esoren/denmark/README.md

This code is for an STM32F4-based amplifier controller board. More info is available on my website.
