esoren/denmark/pcb/denmark_bom.xlsx

Digikey P/N | QTY | Reference | Doubled | Description
399-C0603C104K8RAC7867CT-ND | 10 | C1 C5 C6 C7 C8 C9 C10 C13 C14 C15 | 20 | 100nf 0603 capacitor
587-GMK316AB7475MLHTCT-ND | 2 | C3 C11 | 4 | 4.7uF 1206 low ESR
1189-1513-1-ND | 1 | C2 | 2 | 10uF 8mm cap
475-1410-1-ND | 6 | MODE1 MODE2 MODE3 MODE4 STAT1 STAT2 | 12 | green 0805 led
732-4987-1-ND | 4 | MON1 MON2 MON3 MON4 | 8 | yellow 0805 led
475-1278-1-ND | 6 | FAULT1 FAULT2 FAULT3 FAULT4 FAULT5 FAULT6 | 12 | red 0805 led
497-STM32F401RET7-ND | 1 | U1 | 2 | stm32f4 mcu
RNCP0603FTD1K00CT-ND | 4 | R3 R8 | 8 | 1k 0603 resistor
311-100KHRCT-ND | 3 | R4 R5 R6 | 6 | 100k 0603 resistor
311-2.20KHRCT-ND | 2 | R7 R9 | 4 | 2.2k 0603 resistor
RMCF0201FT10K0CT-ND | 7 | R11 R19 R21 R23 R24 R26 R31 | 14 | 10k 0603 resistor
311-4.7KGRCT-ND | 2 | R17 R18 | 4 | 4.7k 0603 resistor
RMCF0603ZT0R00CT-ND | 3 | R14 R15 R16 | 6 | 0 0603 resistor
VSSR16-330-JI-ND | 2 | R1 R2 | 4 | resistor network - 330
865-1261-1-ND | 1 | U2 | 2 | FRAM
497-1242-1-ND | 1 | IC2 | 2 | 1117 LDO
XC1922-ND | 1 | Q1 | 2 | 8.0 MHz Crystal
CP-1408-ND | 1 | RCA | 2 | RCA connector
102-4000-ND | 1 | USB | 2 | USB connector
296-SN74AHC1G08DBV3CT-ND | 1 | IC1 | 2 | AND Gate
SW400-ND | 5 | S1 S2 S3 S4 S5 | 10 | tactile switch
A98333-ND | 6 | 5V THERM1 THERM2 THERM3 X1 X4 | 12 | 2 pin terminal block 0.1"
A98334-ND | 4 | X2 LF_AMP MF_AMP HF_AMP | 8 | 3 pin terminal block 0.1":
A98335-ND | 1 | FAN | 2 | 4 pin terminal block 0.1"
A98336-ND | 1 | X3 | 2 | 5 pin terminal block 0.1"
MMBT3904LT1HTSA1CT-ND | 7 | T1 T2 T3 T5 T6 T7 T9 | 14 | npn transistor sot23
1276-1187-1-ND | 2 | C4 C12 | 4 | 20p 0603 capacitor
CR0603-JW-331ELFCT-ND | 2 | R29 R30 | 4 | 330 0603 resistor
118-CR0603-JW-221ELFCT-ND | 1 | R12 | 2 | 220 0603 resistor
CR0603-JW-471ELFCT-ND | 1 | R13 | 2 | 470 0603 resistor
2N7002-FDICT-ND | 1 | T8 | 2 | NMOS switch
1727-2097-1-ND | 1 | D1 | 2 | 3v3 zener diode
