esoren/denmark/pcb/denmark.brd

## EAGLE design pcb/denmark.brd (2023-03-16)

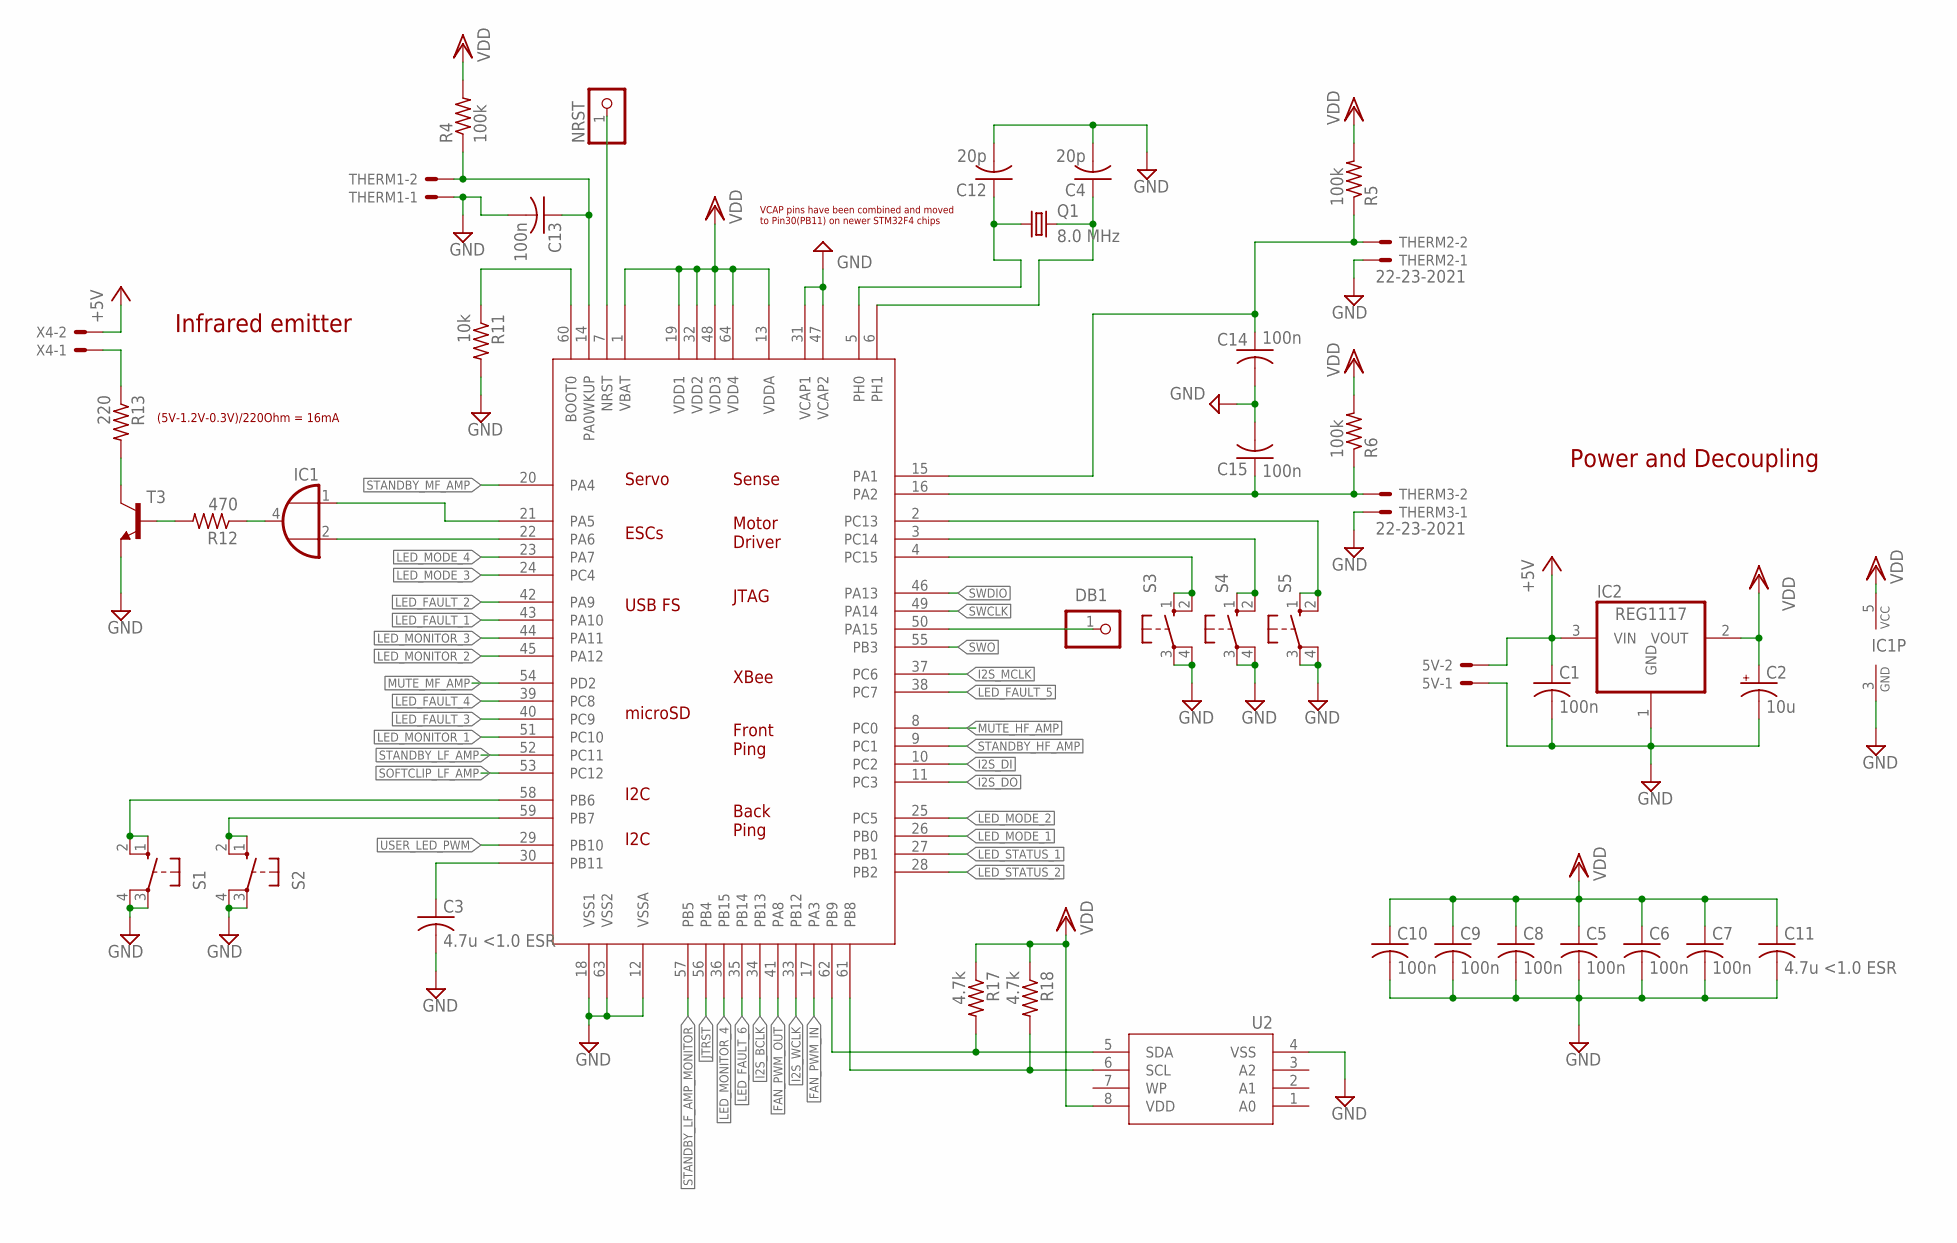
[picture p1: schematic denmark.sch, sheet 1]

Parts:
5V: 22-23-2021
C1: 100n; C0805
C2: 10u; E3,5-8
C3, C11: 4.7u <1.0 ESR; C1206
C4, C12: 20p; C0603K
C5, C6, C7, C8, C9, C10, C13, C14, C15: 100n; C0603K
DB1: PINHD-1X1; 1X01
IC1: 74AHC1G32DBV; SOT23-5
IC2: REG1117; SOT223
NRST: PINHD-1X1; 1X01
Q1: 8.0 MHz; HC49U-V
R4, R5, R6: 100k; R0603
R11: 10k; R0603
R12: 470; R0603
R13: 220; R0603
R17, R18: 4.7k; R0603
S1, S2, S3, S4, S5: 10-XX; B3F-10XX
T3: MMBT3904LT1-NPN-SOT23-BEC; SOT23-BEC
THERM1, THERM2, THERM3: 22-23-2021
U1: STM32F4_10X10_LQFP64; LQFP-ST-64-2
U2: MB85RCSOIC8; SOIC8
X4: 22-23-2021

Connections:
+5V: 5V.2, C1.1, IC2.3 (VIN), X4.2; also elsewhere on the board
BUTTON1_INPUT: S1.1 (S), S1.2 (S1), U1.58 (PB6)
BUTTON2_INPUT: S2.1 (S), S2.2 (S1), U1.59 (PB7)
BUTTON3_INPUT: S3.1 (S), S3.2 (S1), U1.4 (PC15)
BUTTON4_INPUT: S4.1 (S), S4.2 (S1), U1.3 (PC14)
BUTTON5_INPUT: S5.1 (S), S5.2 (S1), U1.2 (PC13)
FAN_PWM_IN: U1.17 (PA3); also elsewhere on the board
FAN_PWM_OUT: U1.41 (PA8); also elsewhere on the board
GND: 5V.1, C1.2, C2.-, C3.2, C4.2, C5.2, C6.2, C7.2, C8.2, C9.2, C10.2, C11.2, C12.2, C13.2, C14.2, C15.2, IC1.3 (GND), IC2.1 (GND), R11.2, S1.3, S1.4 (P1), S2.3, S2.4 (P1), S3.3, S3.4 (P1), S4.3, S4.4 (P1), S5.3, S5.4 (P1), T3.E, THERM1.1, THERM2.1, THERM3.1, U1.12 (VSSA), U1.18 (VSS1), U1.31 (VCAP1), U1.47 (VCAP2), U1.63 (VSS2), U2.4 (VSS); also elsewhere on the board
I2C_SCL: R18.2, U1.61 (PB8), U2.6 (SCL)
I2C_SDA: R17.2, U1.62 (PB9), U2.5 (SDA)
I2S_BCLK: U1.34 (PB13); also elsewhere on the board
I2S_DI: U1.10 (PC2); also elsewhere on the board
I2S_DO: U1.11 (PC3); also elsewhere on the board
I2S_MCLK: U1.37 (PC6); also elsewhere on the board
I2S_WCLK: U1.33 (PB12); also elsewhere on the board
IR_BASE: R12.2, T3.B
IR_CARRIER_OUT: IC1.2 (I1), U1.22 (PA6)
IR_COLLECTOR: R13.2, T3.C
IR_SIGNAL_OUT: IC1.1 (I0), U1.21 (PA5)
JTRST: U1.56 (PB4); also elsewhere on the board
LED_FAULT_1: U1.43 (PA10); also elsewhere on the board
LED_FAULT_2: U1.42 (PA9); also elsewhere on the board
LED_FAULT_3: U1.40 (PC9); also elsewhere on the board
LED_FAULT_4: U1.39 (PC8); also elsewhere on the board
LED_FAULT_5: U1.38 (PC7); also elsewhere on the board
LED_FAULT_6: U1.35 (PB14); also elsewhere on the board
LED_MODE_1: U1.26 (PB0); also elsewhere on the board
LED_MODE_2: U1.25 (PC5); also elsewhere on the board
LED_MODE_3: U1.24 (PC4); also elsewhere on the board
LED_MODE_4: U1.23 (PA7); also elsewhere on the board
LED_MONITOR_1: U1.51 (PC10); also elsewhere on the board
LED_MONITOR_2: U1.45 (PA12); also elsewhere on the board
LED_MONITOR_3: U1.44 (PA11); also elsewhere on the board
LED_MONITOR_4: U1.36 (PB15); also elsewhere on the board
LED_STATUS_1: U1.27 (PB1); also elsewhere on the board
LED_STATUS_2: U1.28 (PB2); also elsewhere on the board
MUTE_HF_AMP: U1.8 (PC0); also elsewhere on the board
MUTE_MF_AMP: U1.54 (PD2); also elsewhere on the board
unnamed: C3.1, U1.30 (PB11)
unnamed: DB1.1, U1.50 (PA15)
unnamed: R11.1, U1.60 (BOOT0)
unnamed: NRST.1, U1.7 (NRST)
unnamed: IC1.4 (O), R12.1
unnamed: R13.1, X4.1
RCC_OSC_IN: C12.1, Q1.1, U1.5 (PH0)
RCC_OSC_OUT: C4.1, Q1.2, U1.6 (PH1)
SOFTCLIP_LF_AMP: U1.53 (PC12); also elsewhere on the board
STANDBY_HF_AMP: U1.9 (PC1); also elsewhere on the board
STANDBY_LF_AMP: U1.52 (PC11); also elsewhere on the board
STANDBY_LF_AMP_MONITOR: U1.57 (PB5); also elsewhere on the board
STANDBY_MF_AMP: U1.20 (PA4); also elsewhere on the board
SWCLK: U1.49 (PA14); also elsewhere on the board
SWDIO: U1.46 (PA13); also elsewhere on the board
SWO: U1.55 (PB3); also elsewhere on the board
THERM1_ANALOG_INPUT: C13.1, R4.1, THERM1.2, U1.14 (PA0WKUP)
THERM2_ANALOG_INPUT: C14.1, R5.1, THERM2.2, U1.15 (PA1)
THERM3_ANALOG_INPUT: C15.1, R6.1, THERM3.2, U1.16 (PA2)
USER_LED_PWM: U1.29 (PB10); also elsewhere on the board
VDD: C2.+, C5.1, C6.1, C7.1, C8.1, C9.1, C10.1, C11.1, IC1.5 (VCC), IC2.2 (VOUT), R4.2, R5.2, R6.2, R17.1, R18.1, U1.1 (VBAT), U1.13 (VDDA), U1.19 (VDD1), U1.32 (VDD2), U1.48 (VDD3), U1.64 (VDD4), U2.8 (VDD); also elsewhere on the board

Notes on the sheet:
Power and Decoupling
(5V-1.2V-0.3V)/220Ohm = 16mA
Infrared emitter
VCAP pins have been combined and moved to Pin30(PB11) on newer STM32F4 chips

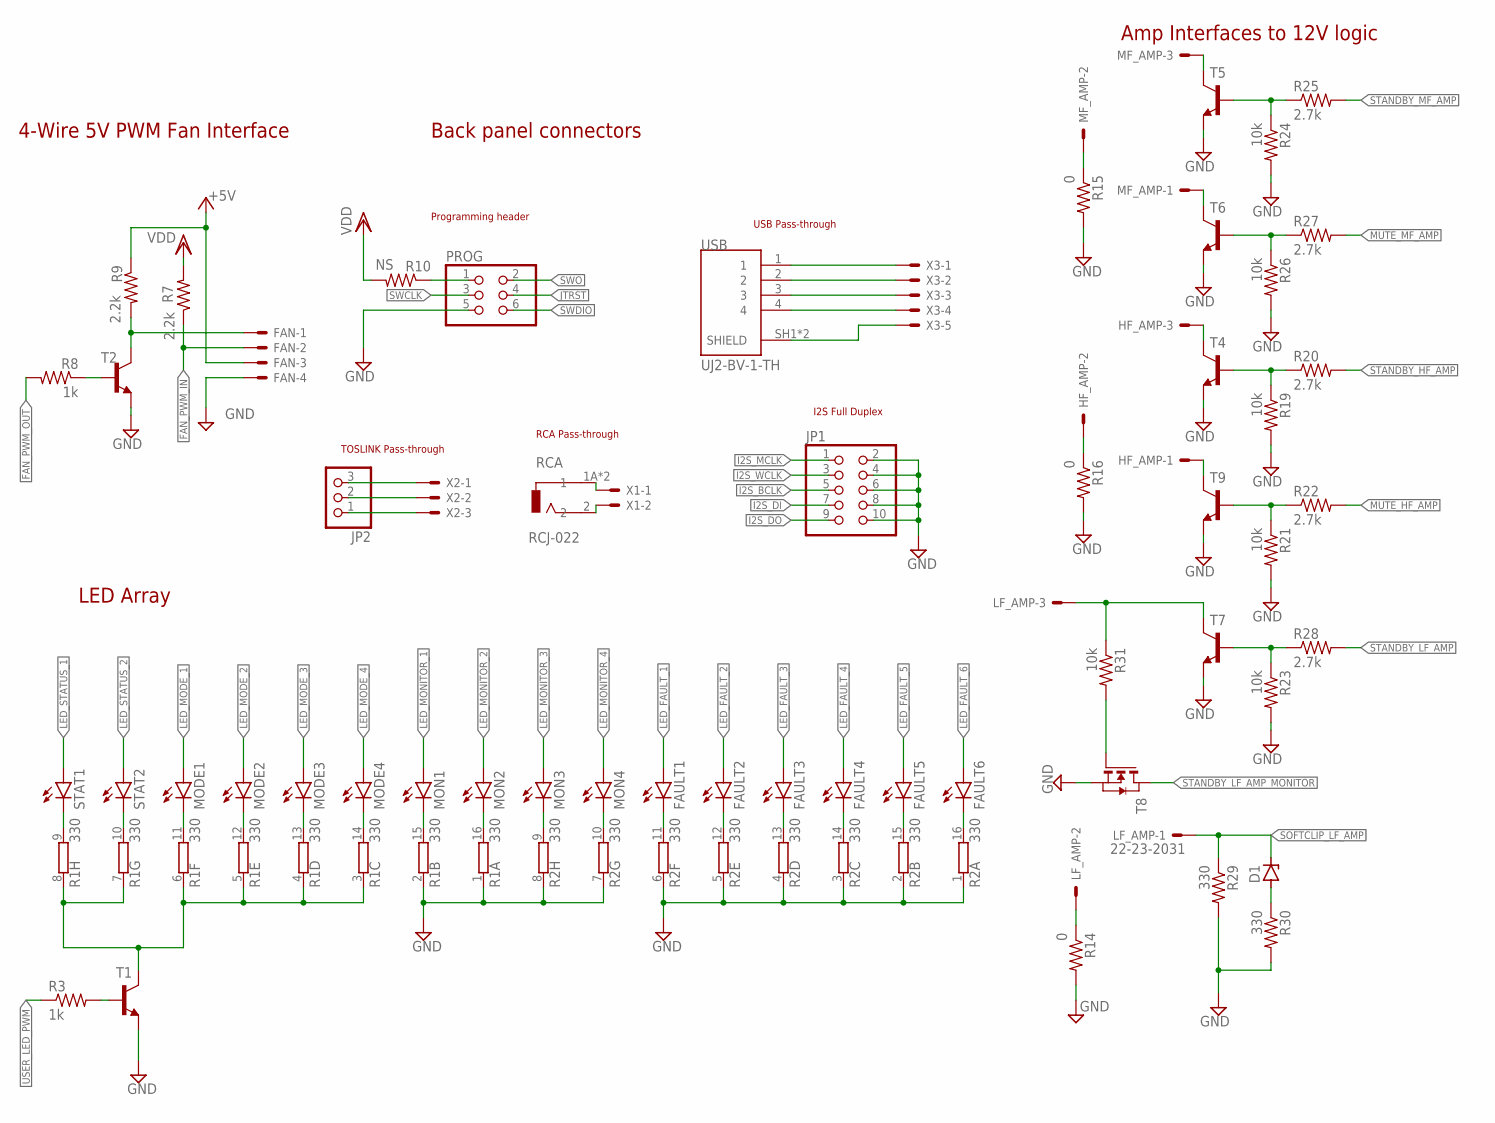
[picture p2: schematic denmark.sch, sheet 2, Input/Output]

Parts:
D1: ZENER-DIODESOD80C; SOD80C
FAN: 22-23-2041
FAULT1, FAULT2, FAULT3, FAULT4, FAULT5, FAULT6: LEDCHIPLED_0805; CHIPLED_0805
HF_AMP: 22-23-2031
JP1: PINHD-2X5; 2X05
JP2: PINHD-1X3; 1X03
LF_AMP: 22-23-2031
MF_AMP: 22-23-2031
MODE1, MODE2, MODE3, MODE4: LEDCHIPLED_0805; CHIPLED_0805
MON1, MON2, MON3, MON4: LEDCHIPLED_0805; CHIPLED_0805
PROG: PINHD-2X3; 2X03
R1, R2: 330; SO16
R3, R8: 1k; R0603
R7, R9: 2.2k; R0603
R10: NS; R0603
R14, R15, R16: 0; R0603
R19, R21, R23, R24, R26, R31: 10k; R0603
R20, R22, R25, R27, R28: 2.7k; R0603
R29, R30: 330; R0603
RCA: RCJ-022; CUI_RCJ-022
STAT1, STAT2: LEDCHIPLED_0805; CHIPLED_0805
T1, T2, T4, T5, T6, T7, T9: MMBT3904LT1-NPN-SOT23-BEC; SOT23-BEC
T8: NMOSSOT23; SOT-23
USB: UJ2-BV-1-TH; CUI_UJ2-BV-1-TH
X1: 22-23-2021
X2: 22-23-2031
X3: 22-23-2051

Connections:
+5V: FAN.3, R9.1; also elsewhere on the board
FAN_PWM_IN: FAN.2, R7.1; also elsewhere on the board
FAN_PWM_OUT: R8.2; also elsewhere on the board
GND: FAN.4, JP1.2, JP1.4, JP1.6, JP1.8, JP1.10, PROG.5, R1.1, R1.2 (1), R2.1, R2.2 (1), R2.3 (1), R2.4 (1), R2.5 (1), R2.6 (1), R2.7 (1), R2.8 (1), R14.2, R15.2, R16.2, R19.2, R21.2, R23.2, R24.2, R26.2, R29.2, R30.2, T1.E, T2.E, T4.E, T5.E, T6.E, T7.E, T8.2 (S), T9.E; also elsewhere on the board
I2S_BCLK: JP1.5; also elsewhere on the board
I2S_DI: JP1.7; also elsewhere on the board
I2S_DO: JP1.9; also elsewhere on the board
I2S_MCLK: JP1.1; also elsewhere on the board
I2S_WCLK: JP1.3; also elsewhere on the board
JTRST: PROG.4; also elsewhere on the board
LED_FAULT_1: FAULT1.A; also elsewhere on the board
LED_FAULT_2: FAULT2.A; also elsewhere on the board
LED_FAULT_3: FAULT3.A; also elsewhere on the board
LED_FAULT_4: FAULT4.A; also elsewhere on the board
LED_FAULT_5: FAULT5.A; also elsewhere on the board
LED_FAULT_6: FAULT6.A; also elsewhere on the board
LED_MODE_1: MODE1.A; also elsewhere on the board
LED_MODE_2: MODE2.A; also elsewhere on the board
LED_MODE_3: MODE3.A; also elsewhere on the board
LED_MODE_4: MODE4.A; also elsewhere on the board
LED_MONITOR_1: MON1.A; also elsewhere on the board
LED_MONITOR_2: MON2.A; also elsewhere on the board
LED_MONITOR_3: MON3.A; also elsewhere on the board
LED_MONITOR_4: MON4.A; also elsewhere on the board
LED_STATUS_1: STAT1.A; also elsewhere on the board
LED_STATUS_2: STAT2.A; also elsewhere on the board
LED_USER_ANODE: R1.3 (1), R1.4 (1), R1.5 (1), R1.6 (1), R1.7 (1), R1.8 (1), T1.C
MUTE_HF_AMP: R22.2; also elsewhere on the board
MUTE_MF_AMP: R27.2; also elsewhere on the board
unnamed: R1.9 (2), STAT1.C
unnamed: R1.10 (2), STAT2.C
unnamed: MODE1.C, R1.11 (2)
unnamed: MODE2.C, R1.12 (2)
unnamed: MODE3.C, R1.13 (2)
unnamed: MODE4.C, R1.14 (2)
unnamed: MON1.C, R1.15 (2)
unnamed: MON2.C, R1.16 (2)
unnamed: MON3.C, R2.9 (2)
unnamed: MON4.C, R2.10 (2)
unnamed: FAULT1.C, R2.11 (2)
unnamed: FAULT2.C, R2.12 (2)
unnamed: FAULT3.C, R2.13 (2)
unnamed: FAULT4.C, R2.14 (2)
unnamed: FAULT5.C, R2.15 (2)
unnamed: FAULT6.C, R2.16 (2)
unnamed: R3.2, T1.B
unnamed: HF_AMP.3, T4.C
unnamed: R19.1, R20.1, T4.B
unnamed: HF_AMP.1, T9.C
unnamed: R21.1, R22.1, T9.B
unnamed: LF_AMP.3, R31.1, T7.C
unnamed: MF_AMP.3, T5.C
unnamed: R24.1, R25.1, T5.B
unnamed: FAN.1, R9.2, T2.C
unnamed: R8.1, T2.B
unnamed: MF_AMP.1, T6.C
unnamed: R26.1, R27.1, T6.B
unnamed: R23.1, R28.1, T7.B
unnamed: RCA.1A (1), RCA.1B (1), X1.1
unnamed: RCA.2, X1.2
unnamed: JP2.3, X2.1
unnamed: JP2.2, X2.2
unnamed: JP2.1, X2.3
unnamed: R31.2, T8.3 (G)
unnamed: USB.1, X3.1
unnamed: USB.2, X3.2
unnamed: USB.3, X3.3
unnamed: USB.4, X3.4
unnamed: USB.SH1 (SHIELD), USB.SH2 (SHIELD), X3.5
unnamed: D1.A, R30.1
unnamed: LF_AMP.2, R14.1
unnamed: MF_AMP.2, R15.1
unnamed: HF_AMP.2, R16.1
SOFTCLIP_LF_AMP: D1.C, LF_AMP.1, R29.1; also elsewhere on the board
STANDBY_HF_AMP: R20.2; also elsewhere on the board
STANDBY_LF_AMP: R28.2; also elsewhere on the board
STANDBY_LF_AMP_MONITOR: T8.1 (D); also elsewhere on the board
STANDBY_MF_AMP: R25.2; also elsewhere on the board
ST_VDD: PROG.1, R10.1
SWCLK: PROG.3; also elsewhere on the board
SWDIO: PROG.6; also elsewhere on the board
SWO: PROG.2; also elsewhere on the board
USER_LED_PWM: R3.1; also elsewhere on the board
VDD: R7.2, R10.2; also elsewhere on the board

Notes on the sheet:
Back panel connectors
LED Array
TOSLINK Pass-through
I2S Full Duplex
USB Pass-through
Programming header
RCA Pass-through
Amp Interfaces to 12V logic
4-Wire 5V PWM Fan Interface

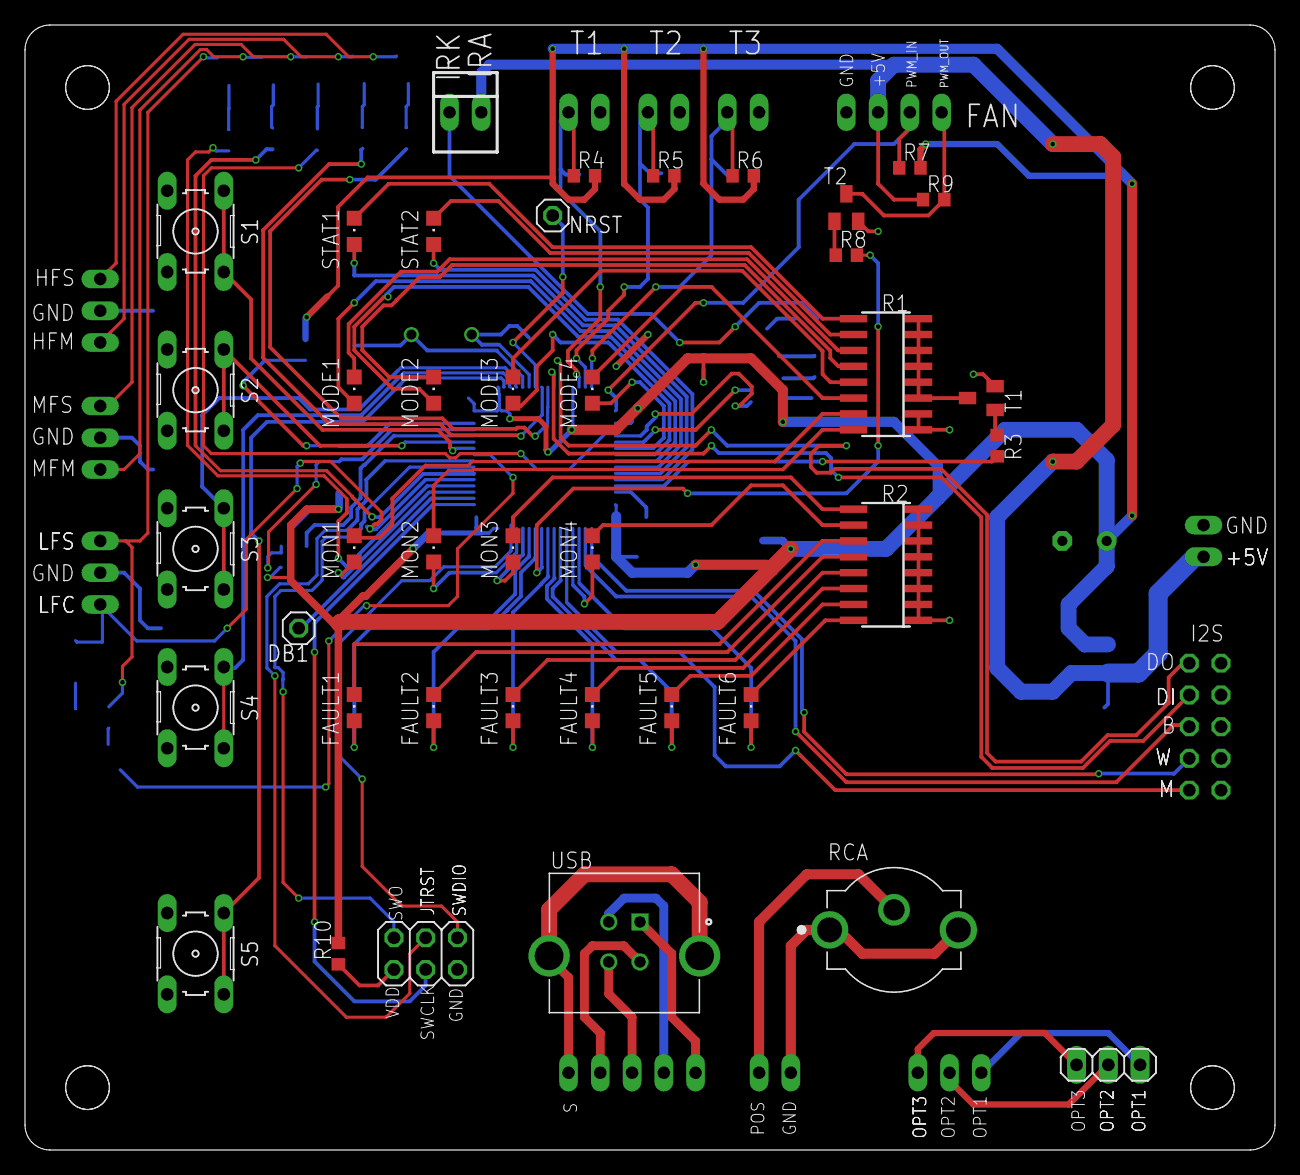
[picture p3: board denmark.brd from above]

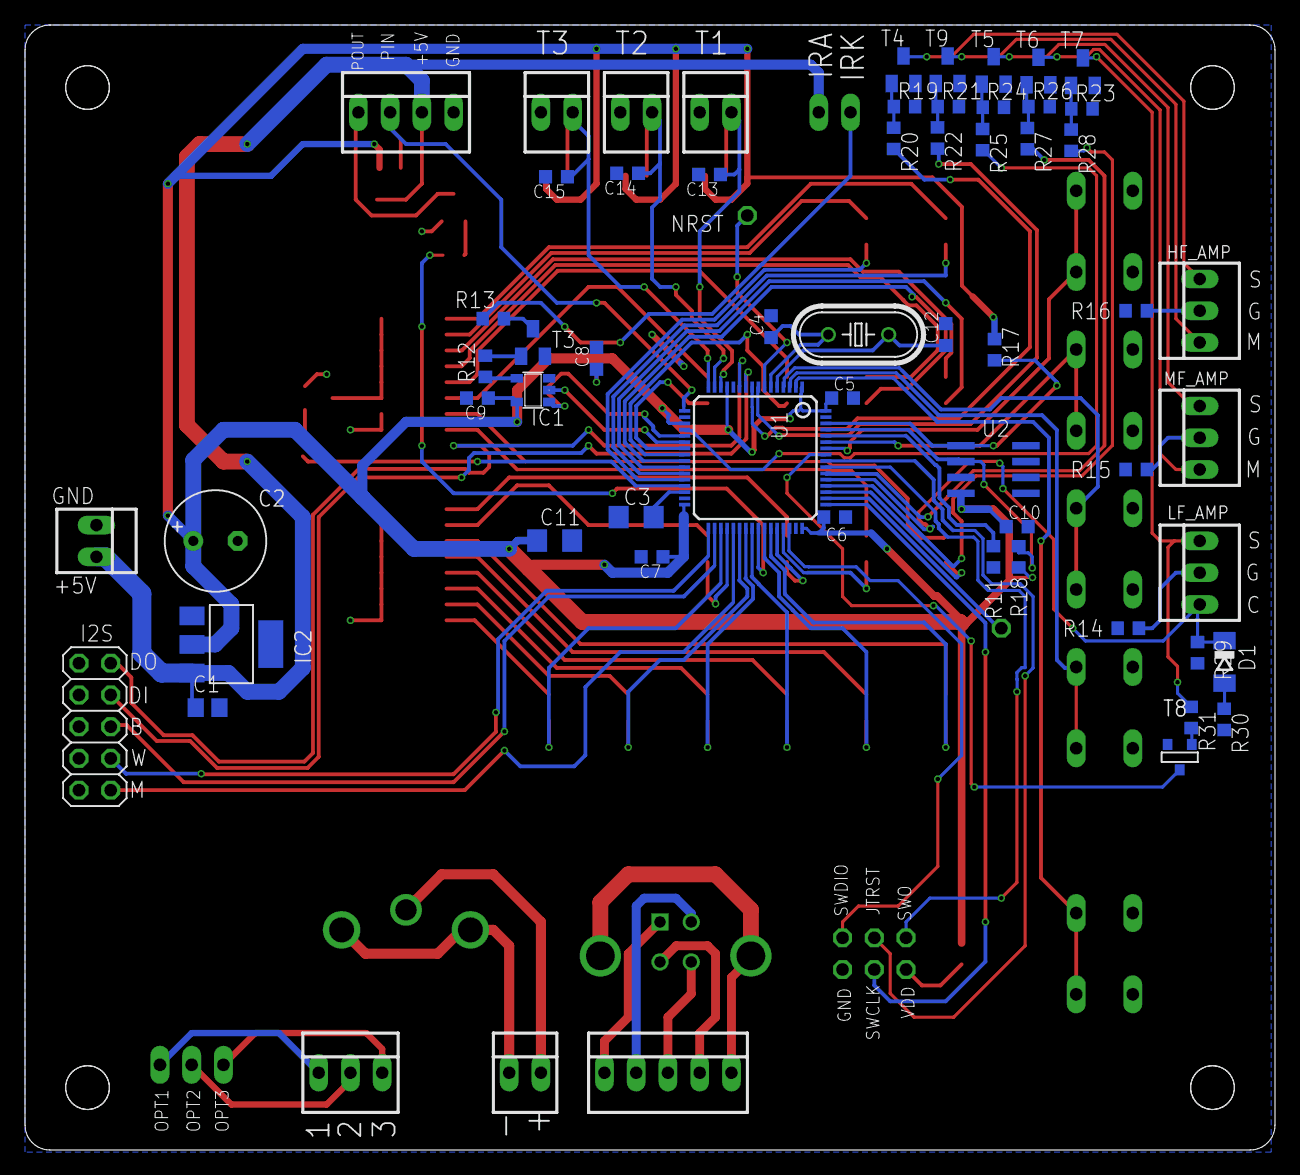
[picture p4: board denmark.brd from below]

Board: 2 copper layers, 100.0 x 90.0 mm, 101 parts (61 on the bottom side), 106 nets.
