esoren/denmark/denmark.ioc

Mcu.UserName=STM32F401RETx
PA0-WKUP.GPIO_Label=THERM1_ANALOG_INPUT
PA0-WKUP.Signal=ADCx_IN0
PA1.GPIO_Label=THERM2_ANALOG_INPUT
PA1.Signal=ADCx_IN1
PA10.GPIO_Label=LED_FAULT_1
PA10.Signal=GPIO_Output
PA11.GPIO_Label=LED_MONITOR_3
PA11.Signal=GPIO_Output
PA12.GPIO_Label=LED_MONITOR_2
PA12.Signal=GPIO_Output
PA13.Signal=SYS_JTMS-SWDIO
PA14.Signal=SYS_JTCK-SWCLK
PA15.Signal=SYS_JTDI
PA2.GPIO_Label=THERM3_ANALOG_INPUT
PA2.Signal=ADCx_IN2
PA3.Signal=S_TIM5_CH4
PA4.GPIO_Label=STANDBY_MF_AMP
PA4.Signal=GPIO_Output
PA5.GPIO_Label=IR_SIGNAL_OUT
PA5.Signal=GPIO_Output
PA6.GPIO_Label=IR_CARRIER_OUT
PA6.Signal=S_TIM3_CH1
PA7.GPIO_Label=LED_MODE_4
PA7.Signal=GPIO_Output
PA8.GPIO_Label=FAN_PWM
PA8.Signal=S_TIM1_CH1
PA9.GPIO_Label=LED_FAULT_2
PA9.Signal=GPIO_Output
PB0.GPIO_Label=LED_MODE_1
PB0.Signal=GPIO_Output
PB1.GPIO_Label=LED_STATUS_1
PB1.Signal=GPIO_Output
PB10.GPIO_Label=USER_LED_PWM
PB10.Signal=S_TIM2_CH3
PB14.GPIO_Label=LED_FAULT_6
PB14.Signal=GPIO_Output
PB15.GPIO_Label=LED_MONITOR_4
PB15.Signal=GPIO_Output
PB2.GPIO_Label=LED_STATUS_2
PB2.Signal=GPIO_Output
PB3.Signal=SYS_JTDO-SWO
PB4.Signal=SYS_JTRST
PB6.GPIO_Label=BUTTON1_INPUT
PB6.Signal=GPIO_Input
PB7.GPIO_Label=BUTTON2_INPUT
PB7.Signal=GPIO_Input
PB8.GPIO_Label=I2C_SCL
PB8.Signal=I2C1_SCL
PB9.GPIO_Label=I2C_SDA
PB9.Signal=I2C1_SDA
PC0.GPIO_Label=MUTE_HF_AMP
PC0.Signal=GPIO_Output
PC1.GPIO_Label=STANDBY_HF_AMP
PC1.Signal=GPIO_Output
PC10.GPIO_Label=LED_MONITOR_1
PC10.Signal=GPIO_Output
PC11.GPIO_Label=STANDBY_LF_AMP_OUTPUT
PC11.Signal=GPIO_Output
PC12.GPIO_Label=SOFTCLIP_LF_AMP_INPUT
PC12.Signal=GPIO_Input
PC13-ANTI_TAMP.GPIO_Label=BUTTON5_INPUT
PC13-ANTI_TAMP.Signal=GPIO_Input
PC14-OSC32_IN.GPIO_Label=BUTTON4_INPUT
PC14-OSC32_IN.Signal=GPIO_Input
PC15-OSC32_OUT.GPIO_Label=BUTTON3_INPUT
PC15-OSC32_OUT.Signal=GPIO_Input
PC3.GPIO_Label=STANDBY_PROTECT_LF_INPUT
PC3.Signal=GPIO_Input
PC4.GPIO_Label=LED_MODE_3
PC4.Signal=GPIO_Output
PC5.GPIO_Label=LED_MODE_2
PC5.Signal=GPIO_Output
PC6.GPIO_Label=GENERAL_INPUT_1
PC6.Signal=GPIO_Input
PC7.GPIO_Label=LED_FAULT_5
PC7.Signal=GPIO_Output
PC8.GPIO_Label=LED_FAULT_4
PC8.Signal=GPIO_Output
PC9.GPIO_Label=LED_FAULT_3
PC9.Signal=GPIO_Output
PD2.GPIO_Label=MUTE_MF_AMP
PD2.Signal=GPIO_Output
