esoren/denmark/(commit log)

2023-03-05 Add internal pullups for button inputs
2023-03-05 Add task for temperature measurement
2023-03-05 Add fault flags and temperature measurement
2023-03-06 Add fan control
2023-03-06 Add fan monitor and fault handling
2023-03-07 Add queue to start and stop temperature monitoring
2023-03-07 Add fan monitor on off control
2023-03-07 Add support for 0 RPM fan setting
2023-03-10 Add standby function and adjust pin settings for board rework
    [denmark.ioc, main.c, main.h, power.c, power.h]
2023-03-11 Add fan speed messages. Standby turns off fan.
2023-03-14 Add pcb board file and schematic
    [denmark.brd, denmark.sch]
2023-03-14 Update MCU footprint and add BOM
    [denmark.brd, denmark.sch, denmark_bom.xlsx]
2023-03-14 Update BOM and PCB to incorporate reworks
    [denmark.brd, denmark.sch, denmark_bom.xlsx]
2023-03-14 Silkscreen cleanup
    [denmark.brd]
2023-03-15 Cleanup Schematic
    [denmark.brd, denmark.sch, denmark_bom.xlsx]
2023-03-15 Update BOM to add 12V interface components
    [denmark.sch, denmark_bom.xlsx]
2023-03-16 Added SWV debug printf function and temperature tracing
2023-03-16 More BOM and schematic cleanup
    [denmark.brd, denmark.sch, denmark_bom.xlsx]
